lindoran/RC39-Backplane-System-for-VZ200/Digital Simulations for GAL/Original VZ200 Logic (for Refrence)/Original Chipset.jpg

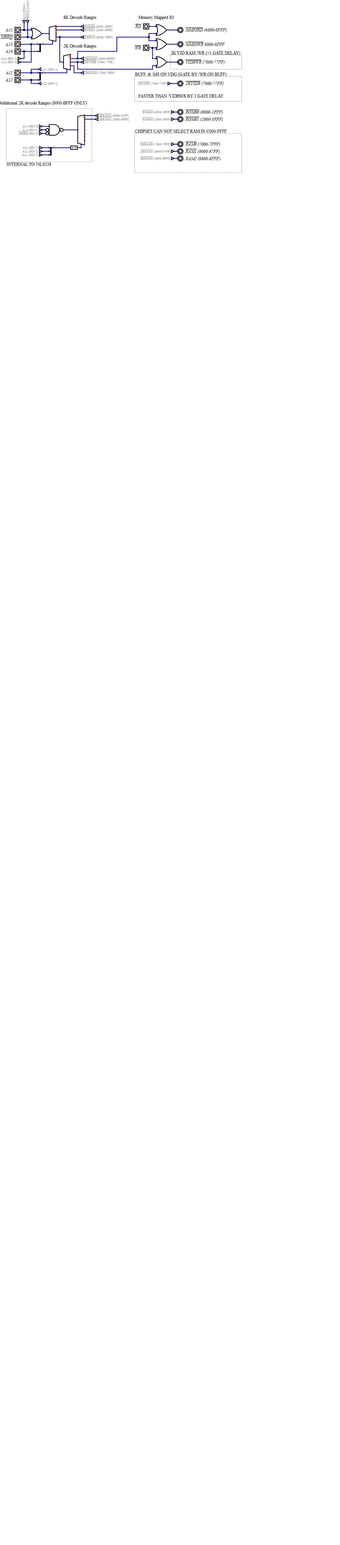
Digital Simulations for GAL/Original VZ200 Logic (for Refrence)/Original Chipset.jpg
