lindoran/RC39-Backplane-System-for-VZ200/Digital Simulations for GAL/Original VZ200 Logic (for Refrence)/Original Chipset.png

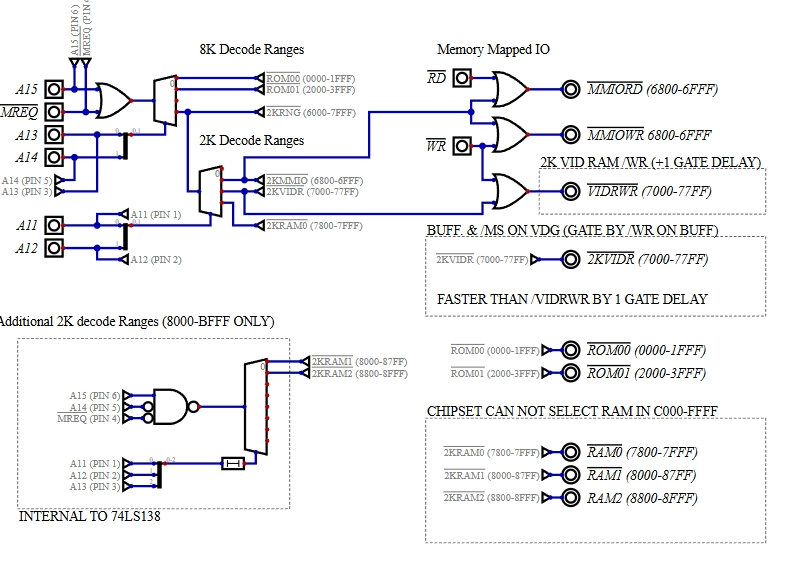
Digital Simulations for GAL/Original VZ200 Logic (for Refrence)/Original Chipset.png
